kamrik/hw-walt/(commit log)

2016-06-17 Initial import
    [WALTsm.kicad_pcb, WALTsm.sch]
2016-06-18 Switch to Letter paper size
    [WALTsm.sch]
2016-06-18 Add default design rules
    Based on OSH park and SeedStudio specs
    http://docs.oshpark.com/design-tools/kicad/kicad-design-rules/
    http://support.seeedstudio.com/knowledgebase/articles/447362-fusion-pcb-specification
    [WALTsm.kicad_pcb]
2016-06-18 Add serial connector
    [WALTsm.sch]
2016-06-19 Add GPIO breakout connector
    A3, A4, A5 pins. A4, A5 are also I2C pins
    [WALTsm.sch]
2016-06-19 Add BMI160 IMU chip
    [WALTsm.sch]
2016-06-19 Annotate and run check
    [WALTsm.sch]
2016-06-19 Added a bunch of footprints and started lyaout
    [WALTsm.kicad_pcb, WALTsm.sch]
2016-06-19 Move stuff out on PCB
    [WALTsm.kicad_pcb]
2016-06-19 Reduce holes on teensy footprint
    [WALTsm.kicad_pcb]
2016-06-19 Fixed TRRS pins, reduced pads in footprints
    [WALTsm.kicad_pcb, WALTsm.sch]
2016-06-19 Reduce pads on Teensy
2016-06-19 Add 6 pin header connector with small pads
2016-06-19 Add mounting holes
    [WALTsm.kicad_pcb]
2016-06-19 Reduce non silk font size
    [WALTsm.kicad_pcb]
2016-06-19 Fix font thickness error
    [WALTsm.kicad_pcb]
2016-06-19 Add power-gnd cap for ADXL335
    [WALTsm.kicad_pcb, WALTsm.sch]
2016-06-19 Placed first traces
    [WALTsm.kicad_pcb]
2016-06-19 Fully routed 1st version
    [WALTsm.kicad_pcb]
2016-06-19 Same as before + fills on both sides
    [WALTsm.kicad_pcb]
2016-06-19 Duplicate connectors
    [WALTsm.kicad_pcb, WALTsm.sch]
2016-06-19 Added text in a bunch of places
    [WALTsm.kicad_pcb, WALTsm.sch]
2016-06-19 Looks done
    [WALTsm.kicad_pcb]
2016-06-19 Looks done but DRC complains about unconnected pads
    Seems to be a KiCAD bug
    https://bugs.launchpad.net/kicad/+bug/593753
    [WALTsm.kicad_pcb]
2016-06-20 No real changes
    [WALTsm.kicad_pcb]
2016-06-20 Chang most holes to 1mm
    Switch back to 1 breakout connector
    [WALTsm.sch]
2016-06-20 Center Photodiode, add thermal reliefs
    [WALTsm.kicad_pcb]
2016-06-20 Fix hole size on serial connector
    [WALTsm.kicad_pcb]
2016-06-20 Add a huge 1mm hole for ground near accelerometer
    [WALTsm.kicad_pcb]
2016-06-20 Change laser photodiode to SMD pads wo holes
    [WALTsm.kicad_pcb]
2016-06-20 Hide some stray REF** on silkscreen
    [WALTsm.kicad_pcb]
2016-06-20 Analog version without BMI160 chip
    [WALTsm.kicad_pcb]
2016-06-22 Remove big pads from paste layer
    Those are not really SMD pads
    [WALTsm.kicad_pcb]
2016-07-12 Add gerbers dir to gitignore
2016-07-12 Add fattened 0603 footprint
2016-07-12 Remove BMI160 and move Serail conn to RX3/TX3
    [WALTsm.sch]
2016-07-12 Add fattened footprint to Rs LEDs in sch file
    [WALTsm.sch]
2016-07-12 PDB changes
    - Moved serial connector down to RX3/TX3
    - Moved debug LEDs to pins 11, 12
    - Change the pig pad for copper tape to thermal relief
    [WALTsm.kicad_pcb]
2016-07-12 Bump rev number on silkscreen
    [WALTsm.kicad_pcb]
2016-08-17 Fix the plastic shape for new PCB
2016-08-18 Fixes after testing
    - Change to using the Y pin on accelerometer
    - Put the photodiode annotation to back side
    - Move a bunch of references that previously overlapped
    - Bump rev to r0.7
    [WALTsm.kicad_pcb, WALTsm.sch]
2016-09-19 Change mic input resistor from 1k to 3.3k
    1k turns out to be at the edge of spec
    https://source.android.com/devices/accessories/headset/specification.html
    At least in one case I saw a Nexus 10 think that I'm pressing the volume down
    button on the headset when WALT was playing the tone. Behaves ok with 2k or
    3.3k resistor.
    [WALTsm.kicad_pcb, WALTsm.sch]
